toyJig/MP3-Business-Card/BOM.csv

Item | Qty | Supplier | Cost/item | Total Cost | link
Custom PCB: 2x w/SMT Assembly | 1 | JLCPCB | $111.38 | $111.38 | https://cart.jlcpcb.com/smt-order/?pcbFileNo=8f168a4dab5c43d380651edf50993458
Estimated total shipping | 1 |  |  | $0.00
