toyJig/MP3-Business-Card/(list of files, drawings)

Other design files:
electronics/freerouting.dsn
electronics/temp-freerouting.dsn
