toyJig/MP3-Business-Card/electronics/Mp3-Business-Card.kicad_pcb

## KiCad design electronics/Mp3-Business-Card.kicad_pcb (2026-11-03)

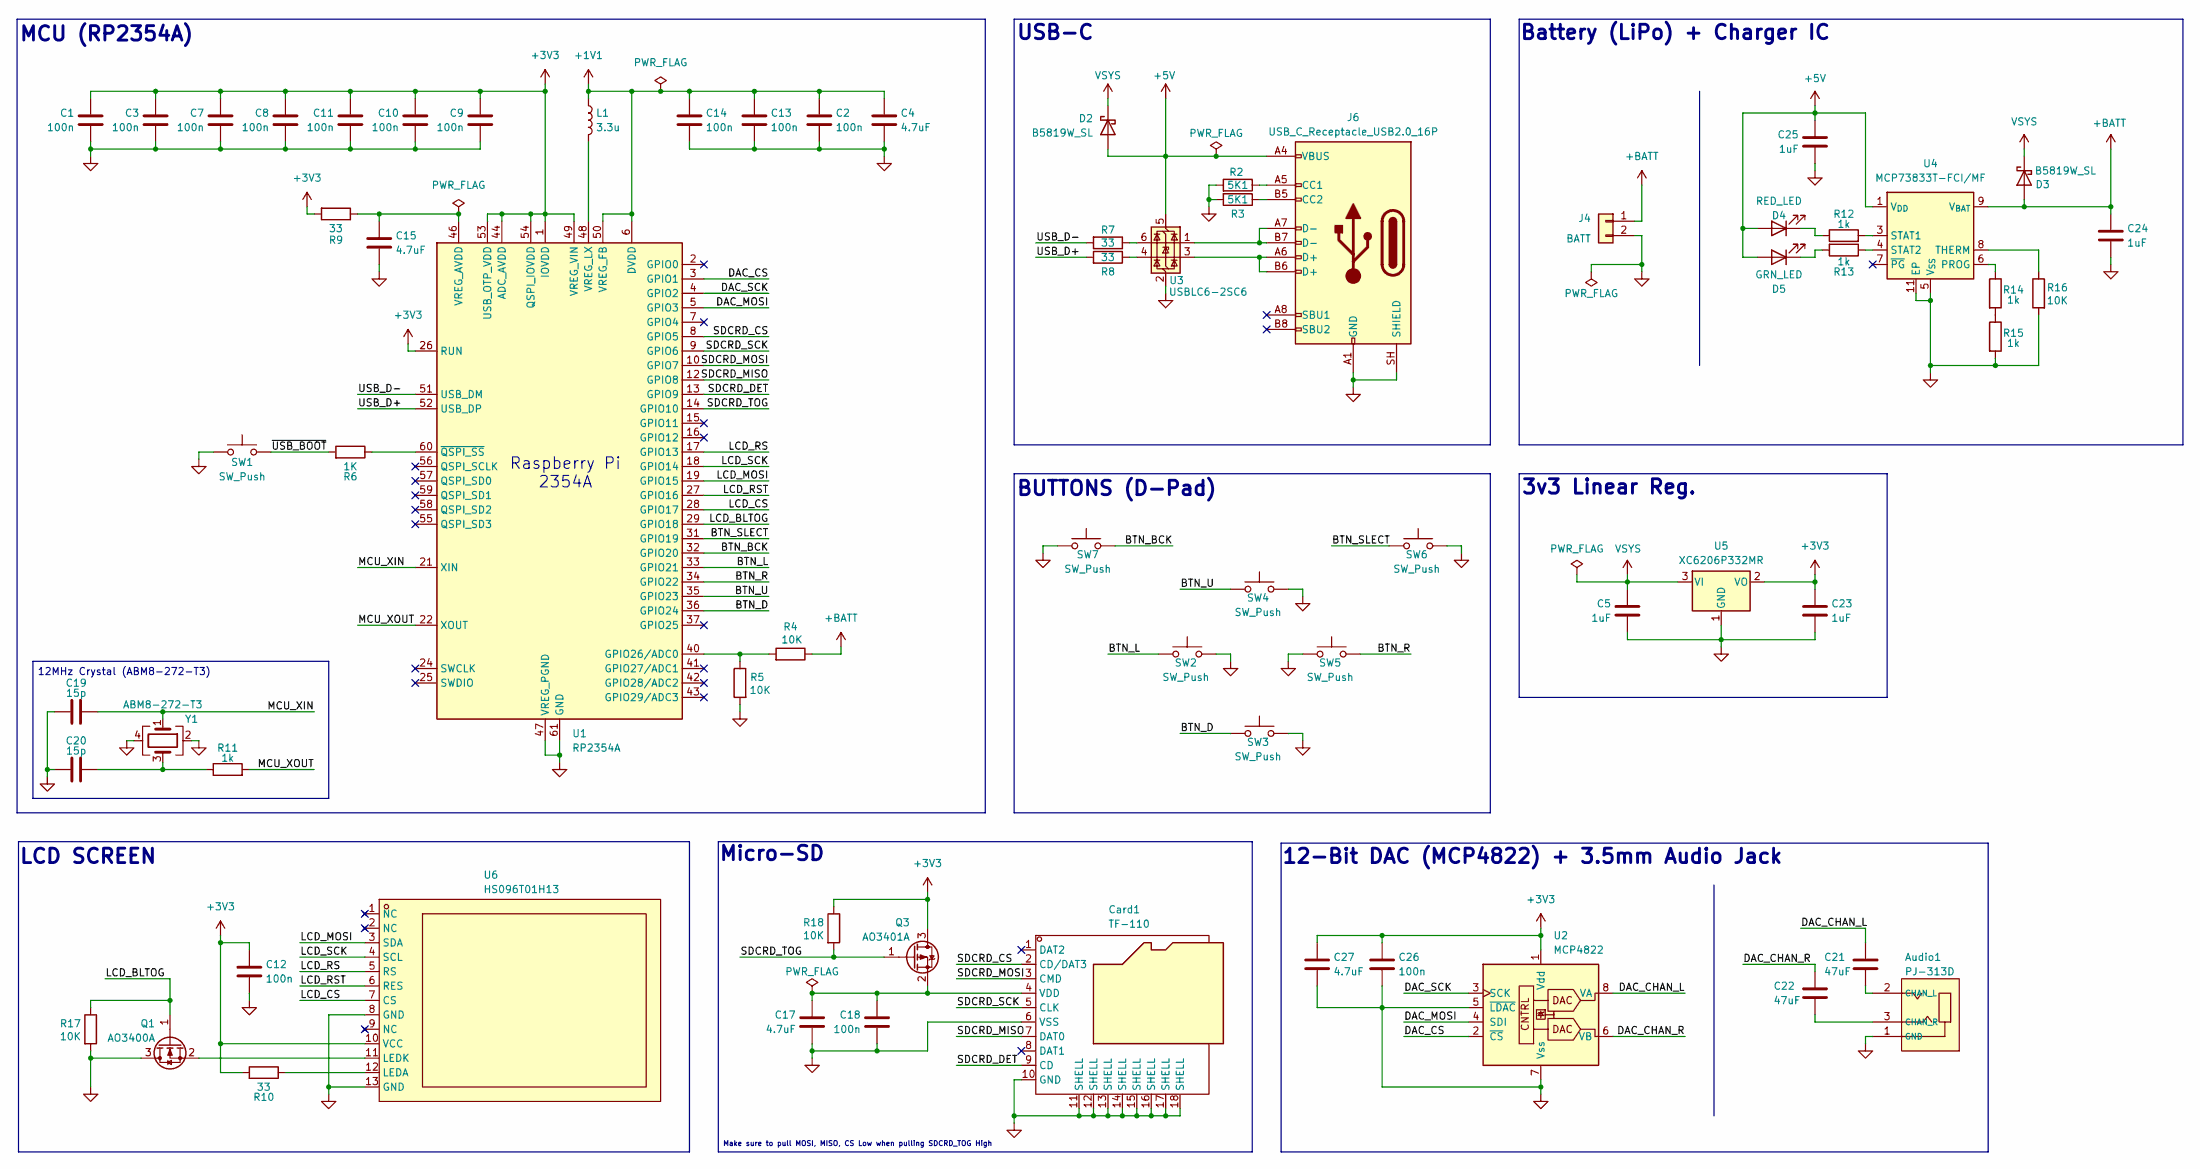
[picture p1: schematic Mp3-Business-Card.kicad_sch, Custom MP3 Player]

Parts:
Audio1: PJ-313D; AUDIO-SMD_PJ-313D; LCSC Part C95463
C1, C2, C3, C7, C8, C9, C10, C11, C12, C13, C14, C18, C26: 100n; C_0402_1005Metric; LCSC C1525
C4, C15, C17, C27: 4.7uF; C_0402_1005Metric; LCSC C1525
C5, C23, C24, C25: 1uF; C_0402_1005Metric; LCSC C1525
C19, C20: 15p; C_0402_1005Metric
C21, C22: 47uF; C_0402_1005Metric; LCSC C1525
Card1: TF-110; TF-SMD_TF-110; LCSC Part C266613
D2, D3: B5819W_SL; D_SOD-123; LCSC C8598
D4: RED_LED; LED_0201_0603Metric
D5: GRN_LED; LED_0201_0603Metric
J4: BATT; TestPoint_2Pads_Pitch5.08mm_Drill1.3mm; LCSC C160315
J6: USB_C_Receptacle_USB2.0_16P; USB_C_Receptacle_GCT_USB4105-xx-A_16P_TopMnt_Horizontal; LCSC C3025063
L1: 3.3u; L_0402_1005Metric
Q1: AO3400A; SOT-23
Q3: AO3401A; SOT-23
R2, R3: 5K1; R_0402_1005Metric; LCSC C25905
R4, R5, R16, R17: 10K; R_0402_1005Metric; LCSC C25905
R6: 1K; R_0402_1005Metric; LCSC C11702
R7, R8, R9, R10: 33; R_0402_1005Metric; LCSC C11702
R11, R12, R13, R14, R15: 1k; R_0402_1005Metric
R18: 10K; R_0603_1608Metric; LCSC C25905
SW1: SW_Push; SW_SPST_TS-1088-xR025; LCSC C269272
SW2, SW3, SW4, SW5, SW6, SW7: SW_Push; SW-SMD_4P-L5.1-W5.1-P3.70-LS6.5-TL_H1.5; LCSC C269272
U1: RP2354A; QFN-60-1EP_7x7mm_P0.4mm_EP3.4x3.4mm
U2: MCP4822; SOIC-8_3.9x4.9mm_P1.27mm
U3: USBLC6-2SC6; SOT-23-6; LCSC C2827654
U4: MCP73833T-FCI/MF; DFN-10-1EP_3x3mm_P0.5mm_EP1.58x2.35mm
U5: XC6206P332MR; SOT-23-3
U6: HS096T01H13; LCD-SMD_HS096T01H13; LCSC Part C18198246
Y1: ABM8-272-T3; Crystal_SMD_3225-4Pin_3.2x2.5mm

Connections:
+1V1: C2.1, C4.1, C13.1, C14.1, L1.1, U1.6 (DVDD), U1.23 (DVDD), U1.39 (DVDD), U1.50 (VREG_FB)
+3V3: C1.1, C3.1, C7.1, C8.1, C9.1, C10.1, C11.1, C12.1, C23.1, C26.1, C27.1, Q3.3 (D), R9.2, R10.2, R18.1, U1.1 (IOVDD), U1.11 (IOVDD), U1.20 (IOVDD), U1.26 (RUN), U1.30 (IOVDD), U1.38 (IOVDD), U1.44 (ADC_AVDD), U1.45 (IOVDD), U1.49 (VREG_VIN), U1.53 (USB_OTP_VDD), U1.54 (QSPI_IOVDD), U2.1 (Vdd), U5.2 (VO), U6.10 (VCC)
+5V: C25.1, D2.2 (A), D4.2 (A), D5.2 (A), J6.A4 (VBUS), J6.A9 (VBUS), J6.B4 (VBUS), J6.B9 (VBUS), U3.5 (VBUS), U4.1 (V_{DD}), U4.2 (V_{DD})
+BATT: C24.1, D3.2 (A), J4.1, R4.1, U4.9 (V_{BAT}), U4.10 (V_{BAT})
/BTN_BCK: SW7.1, U1.32 (GPIO20)
/BTN_D: SW3.1, U1.36 (GPIO24)
/BTN_L: SW2.1, U1.33 (GPIO21)
/BTN_R: SW5.2, U1.34 (GPIO22)
/BTN_SLECT: SW6.1, U1.31 (GPIO19)
/BTN_U: SW4.1, U1.35 (GPIO23)
/DAC_CHAN_L: C21.2, U2.8 (VA)
/DAC_CHAN_R: C22.2, U2.6 (VB)
/DAC_CS: U1.3 (GPIO1), U2.2 (~CS)
/DAC_MOSI: U1.5 (GPIO3), U2.4 (SDI)
/DAC_SCK: U1.4 (GPIO2), U2.3 (SCK)
/LCD_BLTOG: Q1.1 (G), R17.1, U1.29 (GPIO18)
/LCD_CS: U1.28 (GPIO17), U6.7 (CS)
/LCD_MOSI: U1.19 (GPIO15), U6.3 (SDA)
/LCD_RS: U1.17 (GPIO13), U6.5 (RS)
/LCD_RST: U1.27 (GPIO16), U6.6 (RES)
/LCD_SCK: U1.18 (GPIO14), U6.4 (SCL)
/MCU_XIN: C19.2, U1.21 (XIN), Y1.1
/MCU_XOUT: R11.2, U1.22 (XOUT)
/SDCRD_CS: Card1.2 (CD/DAT3), U1.8 (GPIO5)
/SDCRD_DET: Card1.9 (CD), U1.13 (GPIO9)
/SDCRD_MISO: Card1.7 (DAT0), U1.12 (GPIO8)
/SDCRD_MOSI: Card1.3 (CMD), U1.10 (GPIO7)
/SDCRD_SCK: Card1.5 (CLK), U1.9 (GPIO6)
/SDCRD_TOG: Q3.1 (G), R18.2, U1.14 (GPIO10)
/USB_D+: R8.2, U1.52 (USB_DP)
/USB_D-: R7.2, U1.51 (USB_DM)
/~USB_BOOT: R6.2, SW1.2
GND: Audio1.1 (GND), C1.2, C2.2, C3.2, C4.2, C5.2, C7.2, C8.2, C9.2, C10.2, C11.2, C12.2, C13.2, C14.2, C15.2, C17.2, C18.2, C19.1, C20.1, C23.2, C24.2, C25.2, C26.2, C27.2, Card1.6 (VSS), Card1.10 (GND), Card1.11 (SHELL), Card1.12 (SHELL), Card1.13 (SHELL), Card1.14 (SHELL), Card1.15 (SHELL), Card1.16 (SHELL), Card1.17 (SHELL), Card1.18 (SHELL), J4.2, J6.A1 (GND), J6.A12 (GND), J6.B1 (GND), J6.B12 (GND), J6.SH (SHIELD), Q1.3 (D), R2.2, R3.2, R5.2, R15.2, R16.2, R17.2, SW1.1, SW2.2, SW3.2, SW4.2, SW5.1, SW6.2, SW7.2, U1.47 (VREG_PGND), U1.61 (GND), U2.5 (~LDAC), U2.7 (Vss), U3.2 (GND), U4.5 (V_{SS}), U4.11 (EP), U5.1 (GND), U6.8 (GND), U6.13 (GND), Y1.2, Y1.4
unnamed: Audio1.2 (CHAN_L), C21.1
unnamed: Audio1.3 (CHAN_R), C22.1
unnamed: C20.2, R11.1, Y1.3
unnamed: C17.1, C18.1, Card1.4 (VDD), Q3.2 (S)
unnamed: D4.1 (K), R12.1
unnamed: D5.1 (K), R13.2
unnamed: J6.A5 (CC1), R2.1
unnamed: J6.B5 (CC2), R3.1
unnamed: J6.A6 (D+), J6.B6 (D+), U3.3 (I/O2)
unnamed: J6.A7 (D-), J6.B7 (D-), U3.1 (I/O1)
unnamed: Q1.2 (S), U6.11 (LEDK)
unnamed: R7.1, U3.6 (I/O1)
unnamed: R8.1, U3.4 (I/O2)
unnamed: R14.2, R15.1
unnamed: R4.2, R5.1, U1.40 (GPIO26/ADC0)
unnamed: C15.1, R9.1, U1.46 (VREG_AVDD)
unnamed: L1.2, U1.48 (VREG_LX)
unnamed: R6.1, U1.60 (~QSPI_SS)
unnamed: R14.1, U4.6 (PROG)
unnamed: R12.2, U4.3 (STAT1)
unnamed: R13.1, U4.4 (STAT2)
unnamed: R16.1, U4.8 (THERM)
unnamed: R10.1, U6.12 (LEDA)
VSYS: C5.1, D2.1 (K), D3.1 (K), U5.3 (VI)

Notes on the sheet:
Make sure to pull MOSI, MISO, CS Low when pulling SDCRD_TOG High
BUTTONS (D-Pad)
USB-C
Battery (LiPo) + Charger IC
MCU (RP2354A)
3v3 Linear Reg.
Raspberry Pi 2354A
12MHz Crystal (ABM8-272-T3)
12-Bit DAC (MCP4822) + 3.5mm Audio Jack
Micro-SD
LCD SCREEN

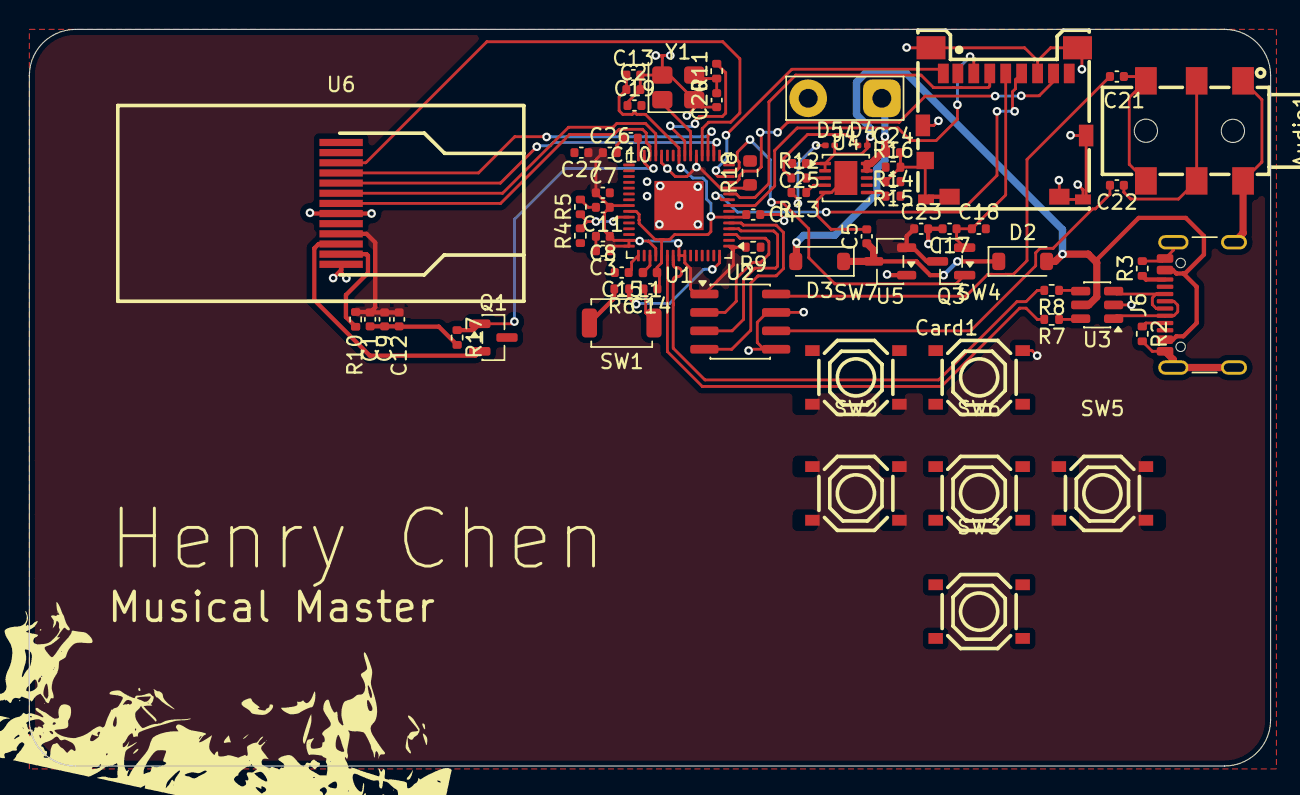
[picture p2: board Mp3-Business-Card.kicad_pcb from above]

Board: 2 copper layers, 85.6 x 50.8 mm, 67 parts (0 on the bottom side), 57 nets.
