toyJig/MP3-Business-Card/JOURNAL.md

# Business Card MP3 Player: devlog

<!-- Generated by Half Life from project qiyfi1oue4tjc3ft76h8ott5. Edits here are overwritten on the next sync. -->
<!-- Generated: 2026-11-03T20:02:44.510Z -->

> [!NOTE]
> This devlog is mirrored from [Half Life](https://halflife.hackclub.com) ([open the project](https://halflife.hackclub.com/projects/qiyfi1oue4tjc3ft76h8ott5)). Editing it here will not change the platform's copy, and the next sync overwrites this file.

> A Mp3 player with headphone jack that should double as a  business card! Must be shaped like one and fit within a budget that is able to be given out to people I meet.

| Week | Tier | Hours logged | Entries |
| --- | --- | --- | --- |
| Week 4 | Tier 2 | 23h | 4 |

## Contents

1. [2026-10-27: I made the potential part spreadsheet of what will go on the device. Despite arduous searching, I can't seem to make all the components draw less than the highest grade coin battery's max current draw](#2026-10-27-i-made-the-potential-part-spreadsheet-of-what-wil)
2. [2026-10-31: Forgot to mention, yes I intended to use a display on this as well.](#2026-10-31-forgot-to-mention-yes-i-intended-to-use-a-display)
3. [2026-11-03: I made more changes to the PCB as I realized I had a couple mistakes when back-checking with datasheets and Gemini. I was missing a few decoupling capacitors like next to the DAC and the output side o](#2026-11-03-i-made-more-changes-to-the-pcb-as-i-realized-i-ha)
4. [2026-11-03: I started wiring the PCB. I know this looks like TERRIBLE wiring, but I REALLY wanted the MCU right next to the screen for aesthetics. Wouldn't it just look terrible if the pico was like, in the middl](#2026-11-03-i-started-wiring-the-pcb-i-know-this-looks-like-t)

## Design

### 2026-10-27: I made the potential part spreadsheet of what will go on the device. Despite arduous searching, I can't seem to make all the components draw less than the highest grade coin battery's max current draw

**3h**

I made the potential part spreadsheet of what will go on the device. Despite arduous searching, I can't seem to make all the components draw less than the highest grade coin battery's max current draw. I never knew coin batteries sucked so much for current draw... I might have to resort to not making it a business card and it'll be encased with a small lipo pouch... Yes this actually took me more than 3 hours of research but lowk don't have more than 3  images.
I just reading MicroSD alone draws more current than most coin batteries can provide...


I also went a head and downloaded a few of the footprints off EasyEDA to get started and modified them a little. Here's the headphone jack footprint:


For some reason I can't use KiCad's footprint editor on linux? I'll figure that out later.


### 2026-10-31: Forgot to mention, yes I intended to use a display on this as well.

**9h**

Forgot to mention, yes I intended to use a display on this as well.
I started wiring everything. I think I'm going to have to resort to a lipo pouch after all.
Downloaded a couple more footprints and models off an EasyEDA extension since their website is stupid and I was highkey ripping my hair out using their laggy website.




Here is the schematic a few hours in:



I'm still not sure about it. Of course, I'm constantly asking myself if anything here needs another capacitor like the LCD screen's backlight input.
Somehow only got 1 error on my first try:

And honestly I don't think it's my fault  (unless I'm stupid) maybe I'm getting pretty good at this?:


I'm also super unsure if I wired the rp2354A correctly since my schematic looks NOTHING like the example on their docs since they used a different drawing. This is the one I'm following (sorry it's rotated I havent set up easy pdf rotation on linux yet)


I'm also using a rp2354 which has built-in flash, not a rp2350 and there isn't really a tutorial on using 2354 so I'm kinda going by intuition and ai which suck at reading pictures like these. A ton of the warnings came from these pins being unspecified when I downloaded the drawing of easyEDA and I had to assign them:



As well as the Micro SD reader:
![image](https://halflife.hackclub-assets.com/sessions/A1g9crjQinL4h8m4FayIpcASMHZiPgLG/acf0b0b59c2a65562e6f896ba3f04c0fbe77fe6a680ecf9650506f7aa755321b.png

Andddd learned that there are exceptions to everything and that not all GND are power input according to kicad


And then I had to deal with kicad not assigning the right footprints even thought I already linked them beforehand and wowzers! No errors!


### 2026-11-03: I made more changes to the PCB as I realized I had a couple mistakes when back-checking with datasheets and Gemini. I was missing a few decoupling capacitors like next to the DAC and the output side o

**6h**

I made more changes to the PCB as I realized I had a couple mistakes when back-checking with datasheets and Gemini. I was missing a few decoupling capacitors like next to the DAC and the output side of the linear regulator:




I had also changed my 50uF capacitors to 47uF ones since 50uF capacitors I've realized aren't standard.
I also added a P-channel MOSFET to the Micro-SD card in order to save as much power as possible when it's not needed. I decided to use a P-Channel instead of a N-Channel since the GPIO pins on the pico aren't high enough above 3v3 to fully open the gate, and if I put it between GND and VSS then that would introduce problems with voltage floating upwards due to the command line pins.


I also changed the MOSFET type to be one that can be controlled to fully open/close with a pico 2's voltage and is still a basic part on JLCPCB.

Upon reading the datasheet again, I realized that the STAT1 and STAT2 pins are actually voltage sinks and not sources. Thus I had to turn them around and tie their anodes to 5v5 instead:


I had also realized that I wasn't actually dividing my voltage correctly to get a battery reading through the ADC pin. Apparently ADC pins draw practically 0 current so the voltage drop is pretty much 0 if it's not also tied to ground like so:


These changes introduced a TON of new ERC checker errors, like around 30, and I had to clean them all up again. A lot of them were actually related to my kicad crashing occasionally and messing up the custom library dependencies when i middle click for some reason. Likely another linux issue.


### 2026-11-03: I started wiring the PCB. I know this looks like TERRIBLE wiring, but I REALLY wanted the MCU right next to the screen for aesthetics. Wouldn't it just look terrible if the pico was like, in the middl

**5h**

I started wiring the PCB. I know this looks like TERRIBLE wiring, but I REALLY wanted the MCU right next to the screen for aesthetics. Wouldn't it just look terrible if the pico was like, in the middle of the board? Also it's just a lot more fun this way. I think I'm going to have to rewire this though. I had considered moving my pins around, but there were actually a lot more trade-offs than one might think. For example, If I moved the display pins from the top side to the left, then the pins involved with the buttons would need to go on the top and that would be even more of a nightmare to wire. I've never used so many via traces in my life.

I also went ahead and roughly 3D Modeled the LCD HS096T01H13 screen for some reason. Don't ask why, I just felt like it.
https://cad.onshape.com/documents/67362369f60f85328142f508/w/f18d904090de24c64018daa0/e/3137deeed35128d6fdb7bcc3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



Before you see it, I want to say that this was an absolute nightmare to wire. I think I'm going to have to rewire everything again after this since I'm still missing a connection to ground with one of the pins and a 3v3 connection but I can't since the area around it is already so crowded with vias. I think I'm going to have to switch some pins around on the rp2350 and make it so the schematic is uglyyyy urgh.
Okay here, I went ahead and wired everything:


As you can see, I'm just missing a 3v3 and gnd connection...


And here's the 3d preview:


I took some inspiration from Toby Fox's stupid business card design (just a funny placeholder):


But this is just a placeholder. I'm going to actually add my contact details  (unlike Toby, unfortunately) and add more decoration to it soon.
