toyJig/MP3-Business-Card/(commit log)

2026-10-12 Feat+Bug: Added a queue and multithreaded the mp3 playback for much smoother playback. Bug: facing memory issues.
    [DAC.cpp, DAC.hpp, Mp3-Prototype.cpp, Mp3Player.hpp]
2026-10-12 Fixed queue and multithread commit
    [Mp3Player.hpp]
2026-10-12 Fix: Actually fixed queue and multithread - My precious nyon finally back 😭 - losing my mind
    [Mp3-Prototype.cpp]
2026-10-16 Feat: Playback at normal pitch + no more audio cutting
2026-10-17 Feat: Massive overhaul to use PIO and DMA - Runs only on one core now! YAY! (Can use other core for display) - Todo: Only handles mono audio. If using stereo it breaks. - Implements two Direct memory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
2026-10-17 Feat: Implemented stereo playback + reorganized. - Formatted everything and moved DMA and PIO stuff to Mp3Player class. - Supports auto sample rate adjustment - Removed unnecessary includes
2026-10-18 Fix+Style: Fixed slow playback + few bugs. More style choices. - Renamed Mp3-prototype in cmake to Mp3-Card. Changed to main.cpp. - Converted all camel case (including library functions) to snake cas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
    [DAC.cpp, DAC.hpp, main.cpp, mp3_player.hpp]
2026-10-18 Style: switched picomp library to my fork
2026-11-03 Sync Business Card MP3 Player from Half Life
    [BOM.csv]
2026-11-03 Initialize README with project details
    Added project description for custom PCB business card.
